whinis/CarRadio/README.md

# CarRadio
An atempt at making a fully featured car radio

There will be folders for each modules of the radio as well as one for the final board and all code needed to run the radio minus the si4689 firmware files
