whinis/CarRadio/Eagle/FmBoard/SI4689_Fm_Module.brd

## EAGLE design Eagle/FmBoard/SI4689_Fm_Module.brd (2016-11-11)

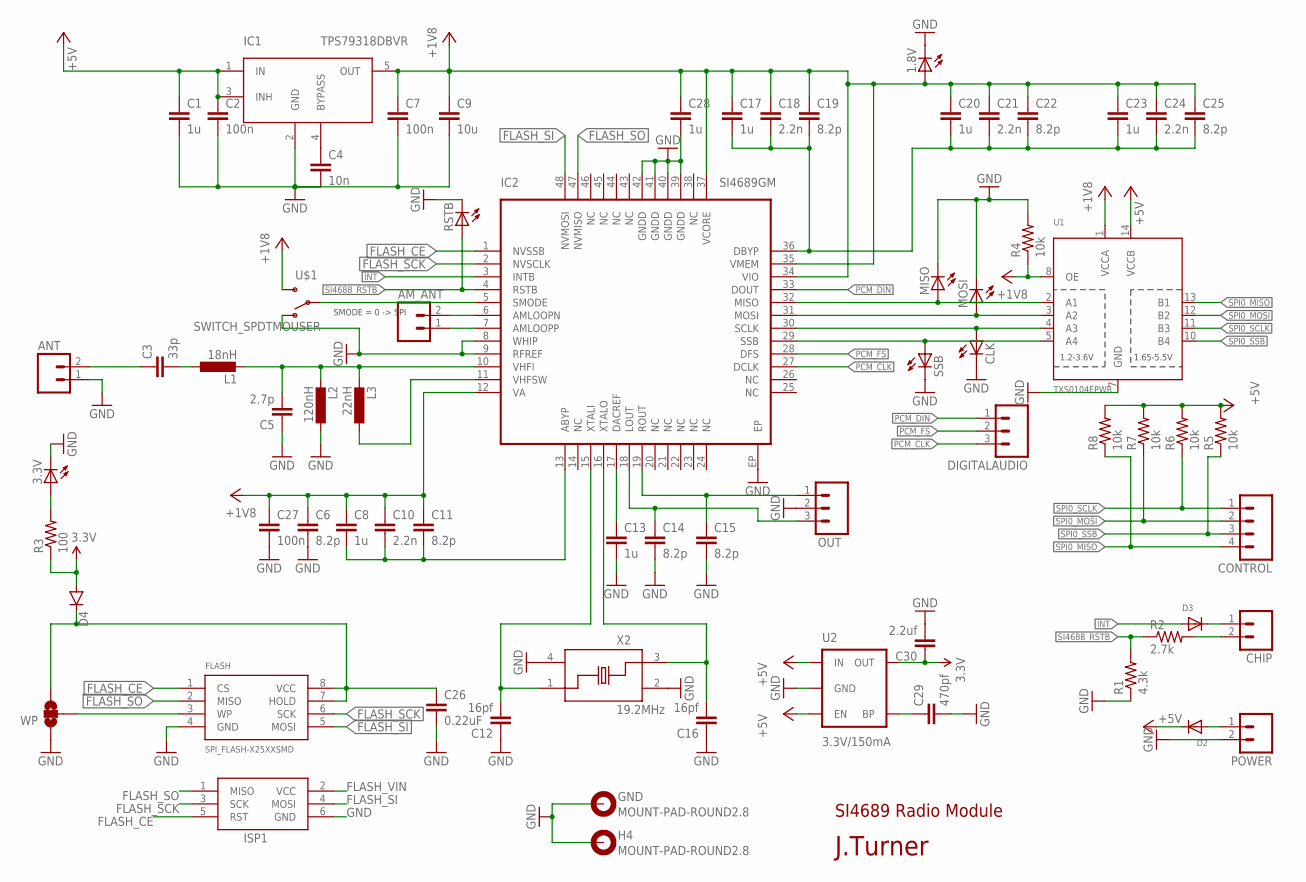
[picture p1: schematic SI4689_Fm_Module.sch]

Parts:
1.8V, 3.3V: LED_ESML0603; LED_SML0603
AM_ANT: M02; 02P
ANT: M02; 02P
C1, C8, C13, C17, C20, C23, C28: 1u; SMD0603
C2, C7, C27: 100n; SMD0603
C3: 33p; 0603-CAP
C4: 10n; SMD0603
C5: 2.7p; 0603-CAP
C6, C11, C14, C15, C19, C22, C25: 8.2p; SMD0603
C9: 10u; SMD0603
C10, C18, C21, C24: 2.2n; SMD0603
C12, C16: 16pf; 0603-CAP
C26: 0.22uF; 0603-CAP
C29: 470pf; 0603-CAP
C30: 2.2uf; 0603-CAP
CHIP: M02; 02P
CLK: LED_ESML0603; LED_SML0603
CONTROL: M04; 04P
D2, D3: DIODESOD-323F; SOD-323F
D4: DIODESOD523; SOD523
DIGITALAUDIO: M03; 03P
FLASH: SPI_FLASH-X25XXSMD; SO08
GND: MOUNT-PAD-ROUND2.8; 2,8-PAD
H4: MOUNT-PAD-ROUND2.8; 2,8-PAD
IC1: TPS79318DBVR; SOT23-5
IC2: SI4689GM; QFN48
ISP1: AVRISP-6; AVRISP
L1: 18nH; SMD0402
L2: 120nH; SMD0402
L3: 22nH; SMD0402
MISO: LED_ESML0603; LED_SML0603
MOSI: LED_ESML0603; LED_SML0603
OUT: M03; 03P
POWER: M02; 02P
R1: 4.3k; 0603-RES
R2: 2.7k; 0603-RES
R3: 100; 0603-RES
R4, R5, R6, R7, R8: 10k; 0603-RES
RSTB: LED_ESML0603; LED_SML0603
SSB: LED_ESML0603; LED_SML0603
U1: TXS0104EPWR; TSSOP14
U2: 3.3V/150mA; SOT23-5
U$1: SWITCH_SPDTMOUSER; SSSS810701
WP: SOLDERJUMPER_2WAYS; SJ_3
X2: 19.2MHz; XTAL_3.2X2.5

Connections:
3.3V: C30.1, D4.A, R3.1, U2.5 (OUT)
+1V8: 1.8V.A, C6.1, C7.1, C8.1, C9.1, C10.1, C11.1, C17.1, C18.1, C19.1, C20.1, C21.1, C22.1, C23.1, C24.1, C25.1, C27.1, C28.1, IC1.5 (OUT), IC2.12 (VA), IC2.34 (VIO), IC2.35 (VMEM), IC2.37 (VCORE), R4.1, U1.1 (VCCA), U1.8 (OE), U$1.S
FLASH_CE: FLASH.1 (CS), IC2.1 (NVSSB), ISP1.5 (RST)
FLASH_SCK: FLASH.6 (SCK), IC2.2 (NVSCLK), ISP1.3 (SCK)
FLASH_SI: FLASH.5 (MOSI), IC2.48 (NVMOSI), ISP1.4 (MOSI)
FLASH_SO: FLASH.2 (MISO), IC2.47 (NVMISO), ISP1.1 (MISO)
FLASH_VIN: C26.1, D4.C, FLASH.7 (HOLD), FLASH.8 (VCC), ISP1.2 (VCC), WP.3
GND: 1.8V.C, 3.3V.C, ANT.1, C1.2, C2.2, C4.2, C5.1, C6.2, C7.2, C9.2, C12.1, C13.2, C14.2, C15.2, C16.1, C26.2, C27.2, C28.2, C29.2, C30.2, CLK.C, FLASH.4 (GND), GND.B2,8, H4.B2,8, IC1.2 (GND), IC2.8 (WHIP), IC2.9 (RFREF), IC2.39 (GNDD), IC2.40 (GNDD), IC2.41 (GNDD), IC2.42 (GNDD), IC2.EP, ISP1.6 (GND), L2.1, MISO.C, MOSI.C, OUT.2, POWER.2, R1.1, R4.2, RSTB.C, SSB.C, U1.7 (GND), U2.2 (GND), U$1.O, WP.1, X2.2 (GND), X2.4 (GND)
INT: D3.A, IC2.3 (INTB)
LDO_IN: C1.1, C2.1, D2.C, IC1.1 (IN), IC1.3 (INH), R5.2, R6.2, R7.2, R8.2, U1.14 (VCCB), U2.1 (IN), U2.3 (EN)
unnamed: C3.2, L1.1
unnamed: C5.2, IC2.10 (VHFI), L1.2, L2.2, L3.2
unnamed: IC2.11 (VHFSW), L3.1
unnamed: C8.2, C10.2, C11.2, IC2.13 (ABYP)
unnamed: C17.2, C18.2, C19.2, C20.2, C21.2, C22.2, C23.2, C24.2, C25.2, IC2.36 (DBYP)
unnamed: C12.2, IC2.15 (XTALI), X2.1
unnamed: C16.2, IC2.16 (XTALO), X2.3
unnamed: C13.1, IC2.17 (DACREF)
unnamed: CHIP.1, D3.C
unnamed: C4.1, IC1.4 (BYPASS)
unnamed: C29.1, U2.4 (BP)
unnamed: 3.3V.A, R3.2
unnamed: FLASH.3 (WP), WP.2
unnamed: AM_ANT.1, IC2.7 (AMLOOPP)
unnamed: AM_ANT.2, IC2.6 (AMLOOPN)
unnamed: IC2.5 (SMODE), U$1.P
unnamed: CHIP.2, R2.2
unnamed: D2.A, POWER.1
PCM_CLK: DIGITALAUDIO.3, IC2.27 (DCLK)
PCM_DIN: DIGITALAUDIO.1, IC2.33 (DOUT)
PCM_FS: DIGITALAUDIO.2, IC2.28 (DFS)
RF_IN: ANT.2, C3.1
SI4688_LOUT: C14.1, IC2.18 (LOUT), OUT.3
SI4688_ROUT: C15.1, IC2.19 (ROUT), OUT.1
SI4688_RSTB: IC2.4 (RSTB), R1.2, R2.1, RSTB.A
SPI0_CE0_N18: IC2.29 (SSB), SSB.A, U1.5 (A4)
SPI0_MISO: CONTROL.4, R8.1, U1.13 (B1)
SPI0_MISO18: IC2.32 (MISO), MISO.A, U1.2 (A1)
SPI0_MOSI: CONTROL.2, R7.1, U1.12 (B2)
SPI0_MOSI18: IC2.31 (MOSI), MOSI.A, U1.3 (A2)
SPI0_SCLK: CONTROL.1, R6.1, U1.11 (B3)
SPI0_SCLK18: CLK.A, IC2.30 (SCLK), U1.4 (A3)
SPI0_SSB: CONTROL.3, R5.1, U1.10 (B4)

Notes on the sheet:
SI4689 Radio Module
SMODE = 0 -> SPI
J.Turner

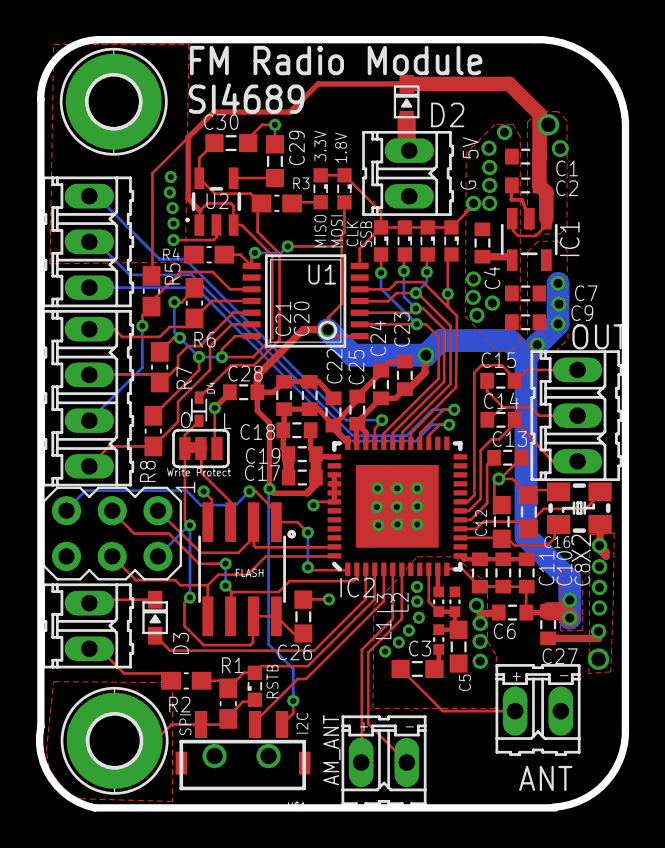
[picture p2: board SI4689_Fm_Module.brd from above]

Board: 2 copper layers, 32.5 x 42.7 mm, 69 parts (0 on the bottom side), 43 nets.
