whinis/CarRadio/Eagle/PowerBoard/power.brd

## EAGLE design Eagle/PowerBoard/power.brd (2016-03-05)

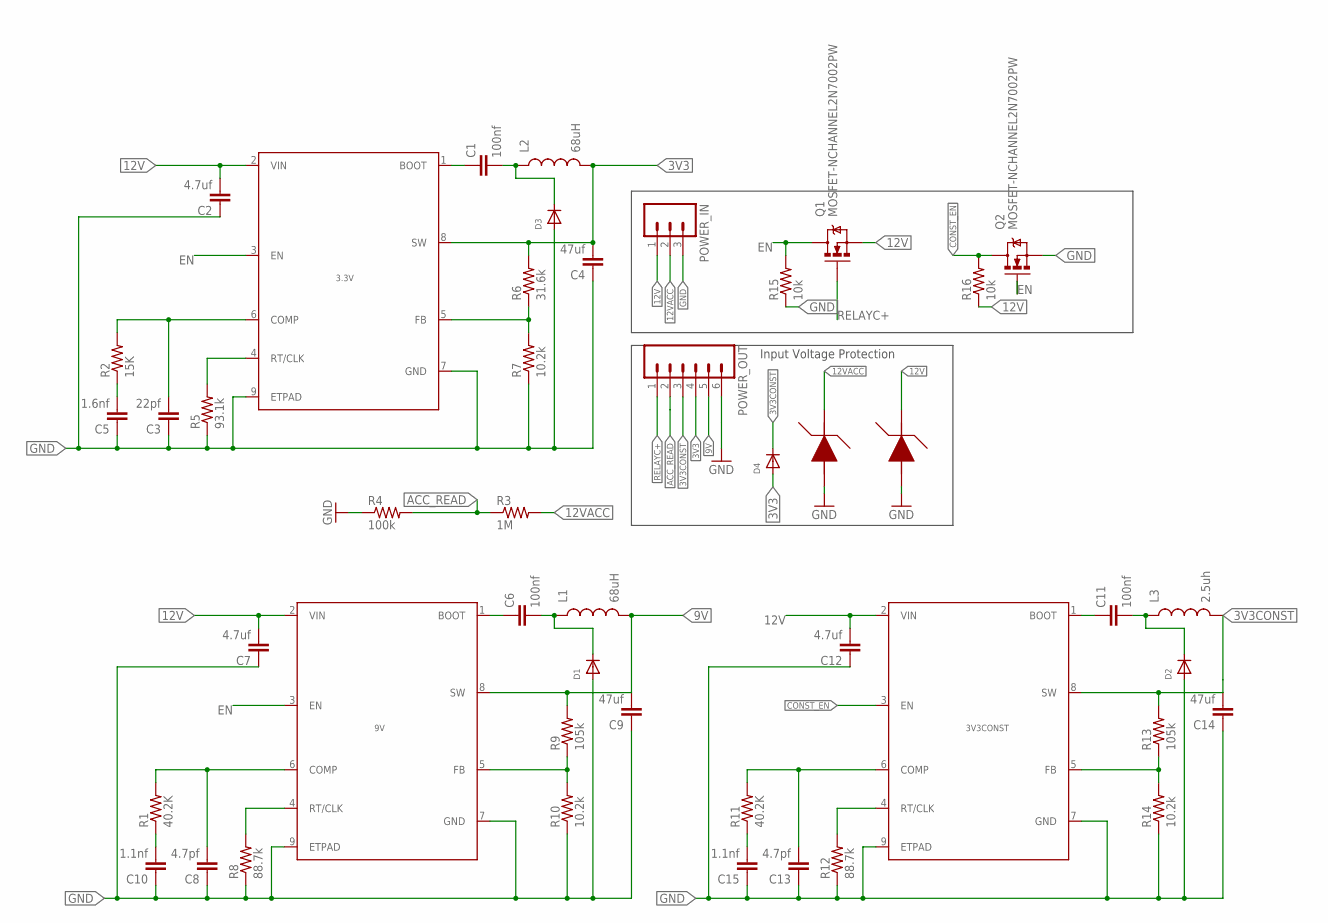
[picture p3: schematic power.sch]

Parts:
3.3V, 3V3CONST, 9V: TPS54340POWERPAD; DDA(R-PDSO-G08)
C1, C6, C11: 100nf; 0603-CAP
C2, C7, C12: 4.7uf; 0603-CAP
C3: 22pf; 0603-CAP
C4, C9, C14: 47uf; 0603-CAP
C5: 1.6nf; 0603-CAP
C8, C13: 4.7pf; 0603-CAP
C10, C15: 1.1nf; 0603-CAP
D1, D2, D3: DIODESOD-323F; SOD-323F
D4: DIODESOD-523; SOD-523
L1, L2: 68uH; CR75
L3: 2.5uh; CR54
POWER_IN: M03; 03P
POWER_OUT: M06; 06P
Q1, Q2: MOSFET-NCHANNEL2N7002PW; SOT323
R1, R11: 40.2K; 0603-RES
R2: 15K; 0603-RES
R3: 1M; 0603-RES
R4: 100k; 0603-RES
R5: 93.1k; 0603-RES
R6: 31.6k; 0603-RES
R7, R10, R14: 10.2k; 0603-RES
R8, R12: 88.7k; 0603-RES
R9, R13: 105k; 0603-RES
R15, R16: 10k; 0603-RES
U$3, U$5: SMCJ12A; DO-214AC

Connections:
3V3: 3.3V.8 (SW), C4.2, D4.A, L2.P$2 (2), POWER_OUT.4, R6.2
3V3CONST: 3V3CONST.8 (SW), C14.2, D4.K (C), L3.P$2 (2), POWER_OUT.3, R13.2
9V: 9V.8 (SW), C9.2, L1.P$2 (2), POWER_OUT.5, R9.2
12V: 3.3V.2 (VIN), 3V3CONST.2 (VIN), 9V.2 (VIN), C2.2, C7.2, C12.2, POWER_IN.1, Q1.2 (S), R16.1, U$5.NEG (GND)
12VACC: POWER_IN.2, R3.2, U$3.NEG (GND)
ACC_READ: POWER_OUT.2, R3.1, R4.2
CONST_EN: 3V3CONST.3 (EN), Q2.3 (D), R16.2
EN: 3.3V.3 (EN), 9V.3 (EN), Q1.3 (D), Q2.1 (G), R15.2
GND: 3.3V.7 (GND), 3.3V.9 (ETPAD), 3V3CONST.7 (GND), 3V3CONST.9 (ETPAD), 9V.7 (GND), 9V.9 (ETPAD), C2.1, C3.1, C4.1, C5.1, C7.1, C8.1, C9.1, C10.1, C12.1, C13.1, C14.1, C15.1, D1.A, D2.A, D3.A, POWER_IN.3, POWER_OUT.6, Q2.2 (S), R4.1, R5.1, R7.1, R8.1, R10.1, R12.1, R14.1, R15.1, U$3.POS (VIN), U$5.POS (VIN)
unnamed: C10.2, R1.1
unnamed: C5.2, R2.1
unnamed: 3.3V.6 (COMP), C3.2, R2.2
unnamed: 3.3V.4 (RT/CLK), R5.2
unnamed: C1.2, D3.C, L2.P$1 (1)
unnamed: 3.3V.5 (FB), R6.1, R7.2
unnamed: 9V.6 (COMP), C8.2, R1.2
unnamed: 3.3V.1 (BOOT), C1.1
unnamed: 9V.4 (RT/CLK), R8.2
unnamed: 9V.5 (FB), R9.1, R10.2
unnamed: 9V.1 (BOOT), C6.1
unnamed: C6.2, D1.C, L1.P$1 (1)
unnamed: C15.2, R11.1
unnamed: 3V3CONST.6 (COMP), C13.2, R11.2
unnamed: 3V3CONST.4 (RT/CLK), R12.2
unnamed: 3V3CONST.5 (FB), R13.1, R14.2
unnamed: 3V3CONST.1 (BOOT), C11.1
unnamed: C11.2, D2.C, L3.P$1 (1)
RELAYC+: POWER_OUT.1, Q1.1 (G)

Notes on the sheet:
Input Voltage Protection

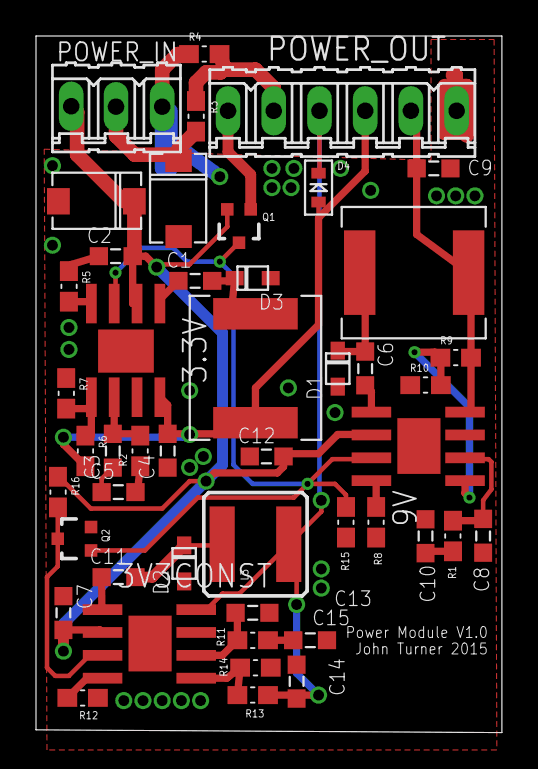
[picture p4: board power.brd from above]

Board: 2 copper layers, 25.9 x 38.7 mm, 47 parts (0 on the bottom side), 28 nets.
