whinis/CarRadio/Eagle/MainBoard/Combo Board.brd

## EAGLE design Eagle/MainBoard/Combo Board.brd (2016-03-05)

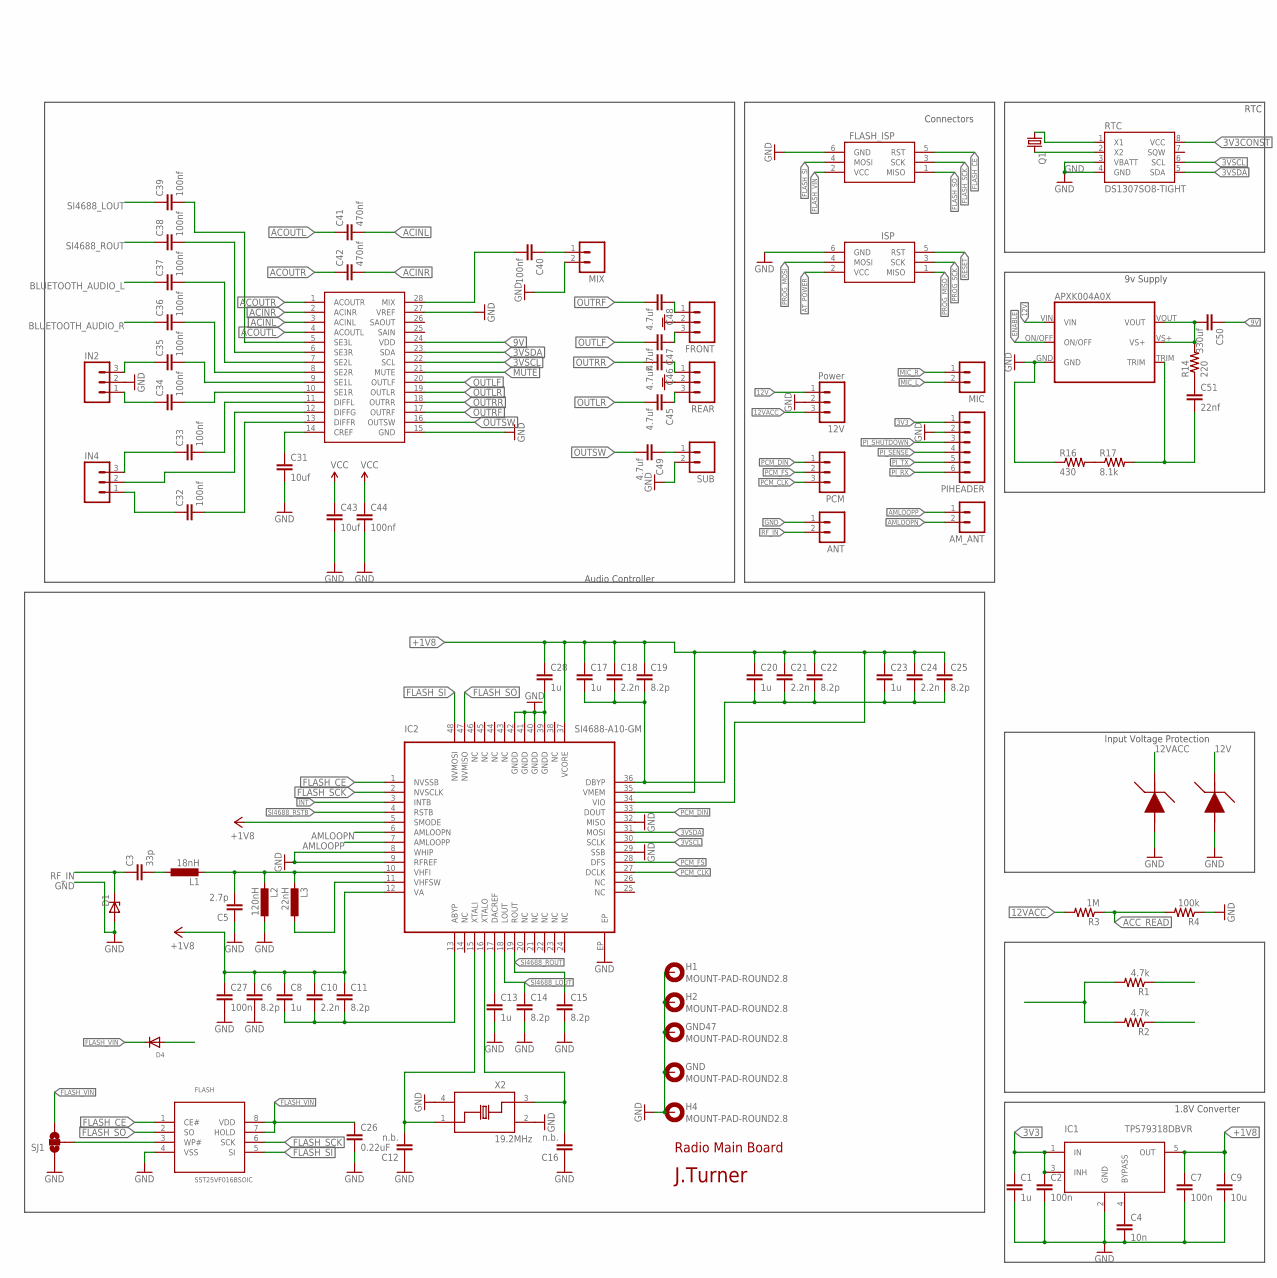
[picture p5: schematic Combo Board.sch, part in row 1, column 1]

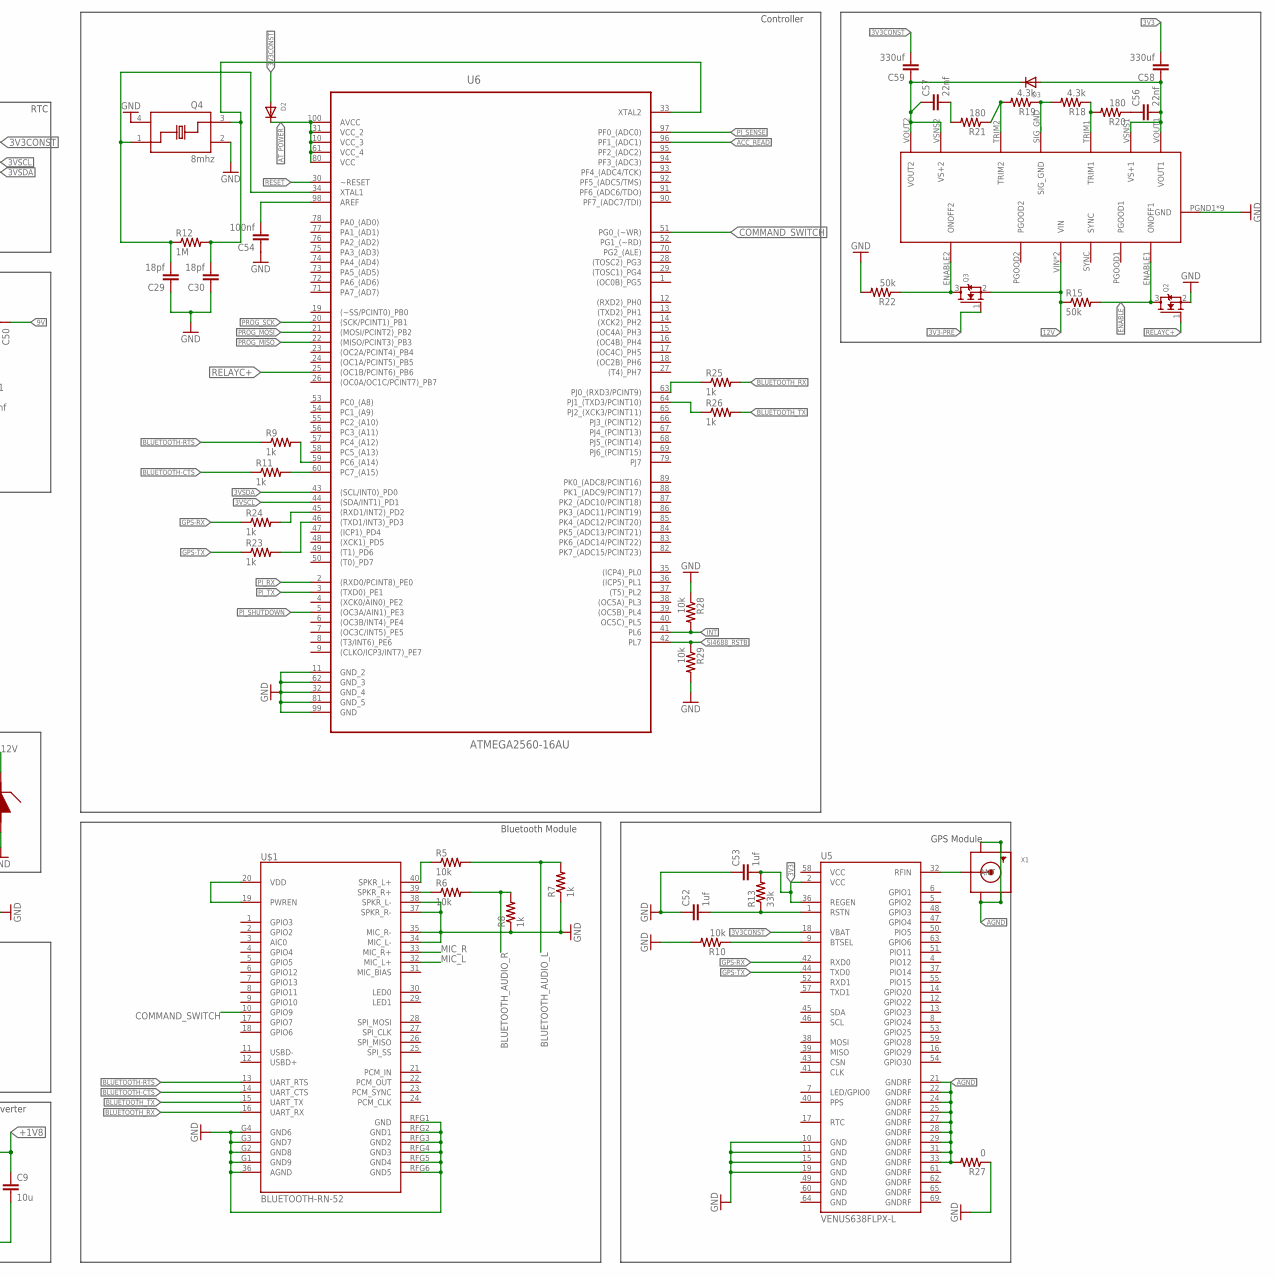
[picture p6: schematic Combo Board.sch, part in row 1, column 2]

Parts:
12V: Power; 03P
AM_ANT: M02; 02P
ANT: M02; 02P
APXK004A0X: APXW005A0X3-SRZ; APXW005A0X3
C1, C8, C13, C17, C20, C23, C28: 1u; SMD0603
C2, C7, C27: 100n; SMD0603
C3: 33p; 0603-CAP
C4: 10n; SMD0603
C5: 2.7p; 0603-CAP
C6, C11, C14, C15, C19, C22, C25: 8.2p; SMD0603
C9: 10u; SMD0603
C10, C18, C21, C24: 2.2n; SMD0603
C12, C16: n.b.; 0603-CAP
C26: 0.22uF; 0603-CAP
C29, C30: 18pf; 0603-CAP
C31, C43: 10uf; 0603-CAP
C32, C33, C34, C35, C36, C37, C38, C39, C40, C44, C54: 100nf; 0603-CAP
C41, C42: 470nf; 0603-CAP
C45, C46, C47, C48, C49: 4.7uf; 0603-CAP
C50, C58, C59: 330uf; 0603-CAP
C51, C56, C57: 22nf; 0603-CAP
C52, C53: 1uf; SMD0603
D1: ESD9L5.0; SOD923
D2: DIODESOD-123; SOD-123
D3, D4: DIODESOD-323F; SOD-323F
FLASH: SST25VF016BSOIC; SOIC8
FLASH_ISP: AVRISP-6; AVRISP
FRONT: M03PTH; 1X03
GND, GND47: MOUNT-PAD-ROUND2.8; 2,8-PAD
H1, H2, H4: MOUNT-PAD-ROUND2.8; 2,8-PAD
IC1: TPS79318DBVR; SOT23-5
IC2: SI4688-A10-GM; QFN48
IN2, IN4: M03; 03P
ISP: AVRISP-6; AVRISP
L1: 18nH; SMD0402
L2: 120nH; SMD0402
L3: 22nH; SMD0402
MIC: M02; 02P
MIX: M02; 02P
PCM: M03; 03P
PIHEADER: M06; 06P
Q1: CRYSTALTC26H_EZ; TC26HEZ
Q2, Q3: MOSFET-NREFLOW; SOT23
Q4: 8mhz; XTAL_3.2X2.5
R1, R2: 4.7k; 0603-RES
R3, R12: 1M; 0603-RES
R4: 100k; 0603-RES
R5, R6, R10, R28, R29: 10k; 0603-RES
R7, R8, R9, R11, R23, R24, R25, R26: 1k; 0603-RES
R13: 33k; 0603-RES
R14: 220; 0603-RES
R15, R22: 50k; 0603-RES
R16: 430; 0603-RES
R17: 8.1k; 0603-RES
R18, R19: 4.3k; 0603-RES
R20, R21: 180; 0603-RES
R27: 0; 0603-RES
REAR: M03PTH; 1X03
RTC: DS1307SO8-TIGHT; SO08-TIGHT
SJ1: SOLDERJUMPER_2WAYS; SJ_3
SUB: M02; 02P
TDA: TDA7419; SOIC-28
U5: VENUS638FLPX-L; VENUS638FLPX
U6: ATMEGA2560-16AU; QFP50P1600X1600X120-100N
U$1: BLUETOOTH-RN-52; RN-52
U$2, U$3: SMCJ12A; DO-214AC
U$4: UVXS0606A0X3-SRZ; UVXS0606
X1: SMACONNECTOR; SMA90_DIP
X2: 19.2MHz; XTAL_3.2X2.5

Connections:
3V3: C1.1, C2.1, C53.2, C58.2, D4.A, IC1.1 (IN), IC1.3 (INH), PIHEADER.1, R1.2, R2.2, R13.2, U5.2 (VCC), U5.36 (REGEN), U$1.19 (PWREN), U$1.20 (VDD)
3V3-PRE: C56.2, C58.1, D3.A, Q3.1 (G), U$4.VOUT1, U$4.VSNS1 (VS+1)
3V3CONST: C59.2, D2.A, RTC.8 (VCC), U5.18 (VBAT)
3VSCL: IC2.30 (SCLK), R1.1, RTC.6 (SCL), TDA.22 (SCL), U6.44 ((SDA/INT1)_PD1)
3VSDA: IC2.31 (MOSI), R2.1, RTC.5 (SDA), TDA.23 (SDA), U6.43 ((SCL/INT0)_PD0)
9V: C43.1, C44.1, C50.1, TDA.24 (VDD)
12V: 12V.1, APXK004A0X.VIN, Q3.2 (S), R15.1, U$3.NEG (GND), U$4.VIN, U$4.VIN2 (VIN)
12VACC: 12V.3, R3.2, U$2.NEG (GND)
+1V8: C6.1, C7.1, C8.1, C9.1, C10.1, C11.1, C17.1, C18.1, C19.1, C20.1, C21.1, C22.1, C23.1, C24.1, C25.1, C27.1, C28.1, IC1.5 (OUT), IC2.5 (SMODE), IC2.12 (VA), IC2.34 (VIO), IC2.35 (VMEM), IC2.37 (VCORE)
ACC_READ: R3.1, R4.2, U6.96 (PF1_(ADC1))
ACINL: C41.2, TDA.3 (ACINL)
ACINR: C42.2, TDA.2 (ACINR)
ACOUTL: C41.1, TDA.4 (ACOUTL)
ACOUTR: C42.1, TDA.1 (ACOUTR)
AGND: R27.2, U5.21 (GNDRF), U5.22 (GNDRF), U5.24 (GNDRF), U5.25 (GNDRF), U5.27 (GNDRF), U5.28 (GNDRF), U5.29 (GNDRF), U5.31 (GNDRF), U5.33 (GNDRF), X1.GND1, X1.GND2, X1.GND3, X1.GND4
AMLOOPN: AM_ANT.2, IC2.6 (AMLOOPN)
AMLOOPP: AM_ANT.1, IC2.7 (AMLOOPP)
AT_POWER: D2.C, ISP.2 (VCC), U6.10 (VCC_3), U6.31 (VCC_2), U6.61 (VCC_4), U6.80 (VCC), U6.100 (AVCC)
BLUETOOTH-CTS: R11.1, U$1.14 (UART_CTS)
BLUETOOTH-RTS: R9.1, U$1.13 (UART_RTS)
BLUETOOTH_AUDIO_L: C37.1, R5.2, R7.2
BLUETOOTH_AUDIO_R: C36.1, R6.2, R8.2
BLUETOOTH_RX: R25.2, U$1.16 (UART_RX)
BLUETOOTH_TX: R26.2, U$1.15 (UART_TX)
COMMAND_SWITCH: U6.51 (PG0_(~WR)), U$1.10 (GPIO9)
CREF: C31.1, TDA.14 (CREF)
DIFFG: IN4.2, TDA.12 (DIFFG)
DIFFL: C33.2, TDA.11 (DIFFL)
DIFFR: C32.2, TDA.13 (DIFFR)
ENABLE: APXK004A0X.ON/OFF, Q2.3 (D), R15.2, U$4.ENABLE1 (ONOFF1)
FLASH_CE: FLASH.1 (CE#), FLASH_ISP.5 (RST), IC2.1 (NVSSB)
FLASH_SCK: FLASH.6 (SCK), FLASH_ISP.3 (SCK), IC2.2 (NVSCLK)
FLASH_SI: FLASH.5 (SI), FLASH_ISP.4 (MOSI), IC2.48 (NVMOSI)
FLASH_SO: FLASH.2 (SO), FLASH_ISP.1 (MISO), IC2.47 (NVMISO)
FLASH_VIN: C26.1, D4.C, FLASH.7 (HOLD), FLASH.8 (VDD), FLASH_ISP.2 (VCC), SJ1.3
GND: 12V.2, ANT.1, APXK004A0X.GND, C1.2, C2.2, C4.2, C5.1, C6.2, C7.2, C9.2, C12.1, C13.2, C14.2, C15.2, C16.1, C26.2, C27.2, C28.2, C29.1, C30.1, C31.2, C43.2, C44.2, C52.1, C53.1, C54.1, D1.A, FLASH.4 (VSS), FLASH_ISP.6 (GND), FRONT.2, GND.B2,8, GND47.B2,8, H1.B2,8, H2.B2,8, H4.B2,8, IC1.2 (GND), IC2.8 (WHIP), IC2.9 (RFREF), IC2.29 (SSB), IC2.32 (MISO), IC2.39 (GNDD), IC2.40 (GNDD), IC2.41 (GNDD), IC2.42 (GNDD), IC2.EP, IN2.2, ISP.6 (GND), L2.1, MIX.2, PIHEADER.2, Q2.2 (S), Q4.2 (GND), Q4.4 (GND), R4.1, R7.1, R8.1, R10.2, R16.1, R22.2, R27.1, R28.1, R29.2, REAR.2, RTC.3 (VBATT), RTC.4 (GND), SJ1.1, SUB.2, TDA.15 (GND), TDA.27 (VREF), U5.10 (GND), U5.11 (GND), U5.15 (GND), U5.19 (GND), U6.11 (GND_2), U6.32 (GND_4), U6.62 (GND_3), U6.81 (GND_5), U6.99 (GND), U$1.34 (MIC_L-), U$1.35 (MIC_R-), U$1.36 (AGND), U$1.37 (SPKR_R-), U$1.38 (SPKR_L-), U$1.G1 (GND9), U$1.G2 (GND8), U$1.G3 (GND7), U$1.G4 (GND6), U$1.RFG1 (GND), U$1.RFG2 (GND1), U$1.RFG3 (GND2), U$1.RFG4 (GND3), U$1.RFG5 (GND4), U$1.RFG6 (GND5), U$2.POS (VIN), U$3.POS (VIN), U$4.PGND1 (GND), U$4.PGND2 (GND), U$4.PGND3 (GND), U$4.PGND4 (GND), U$4.PGND5 (GND), U$4.PGND6 (GND), U$4.PGND7 (GND), U$4.PGND8 (GND), U$4.PGND9 (GND), X2.2 (GND), X2.4 (GND)
GPS-RX: R24.1, U5.42 (RXD0)
GPS-TX: R23.1, U5.44 (TXD0)
INT: IC2.3 (INTB), R28.2, U6.41 (PL6)
MIC_L: MIC.2, U$1.32 (MIC_L+)
MIC_R: MIC.1, U$1.33 (MIC_R+)
MIX: C40.2, TDA.28 (MIX)
MUTE: TDA.21 (MUTE)
unnamed: C3.2, L1.1
unnamed: C5.2, IC2.10 (VHFI), L1.2, L2.2, L3.2
unnamed: IC2.11 (VHFSW), L3.1
unnamed: C8.2, C10.2, C11.2, IC2.13 (ABYP)
unnamed: C17.2, C18.2, C19.2, C20.2, C21.2, C22.2, C23.2, C24.2, C25.2, IC2.36 (DBYP)
unnamed: C12.2, IC2.15 (XTALI), X2.1
unnamed: C16.2, IC2.16 (XTALO), X2.3
unnamed: C13.1, IC2.17 (DACREF)
unnamed: R9.2, U6.59 (PC6_(A14))
unnamed: C4.1, IC1.4 (BYPASS)
unnamed: R11.2, U6.60 (PC7_(A15))
unnamed: C30.2, Q4.3, R12.2, U6.33 (XTAL2)
unnamed: FLASH.3 (WP#), SJ1.2
unnamed: R5.1, U$1.40 (SPKR_L+)
unnamed: R6.1, U$1.39 (SPKR_R+)
unnamed: APXK004A0X.TRIM, C51.2, R17.2
unnamed: C40.1, MIX.1
unnamed: Q1.2, RTC.2 (X2)
unnamed: Q1.1, RTC.1 (X1)
unnamed: C35.1, IN2.3
unnamed: C34.1, IN2.1
unnamed: R23.2, U6.46 ((TXD1/INT3)_PD3)
unnamed: C29.2, Q4.1, R12.1, U6.34 (XTAL1)
unnamed: C33.1, IN4.3
unnamed: C32.1, IN4.1
unnamed: R24.2, U6.45 ((RXD1/INT2)_PD2)
unnamed: R16.2, R17.1
unnamed: R10.1, U5.9 (BTSEL)
unnamed: C52.2, R13.1, U5.1 (RSTN)
unnamed: C48.1, FRONT.1
unnamed: C47.1, FRONT.3
unnamed: C46.1, REAR.1
unnamed: C45.1, REAR.3
unnamed: C49.1, SUB.1
unnamed: APXK004A0X.VOUT, APXK004A0X.VS+, C50.2, R14.2
unnamed: C51.1, R14.1
unnamed: R19.2, R21.1, U$4.TRIM2
unnamed: R18.1, R20.2, U$4.TRIM1
unnamed: C56.1, R20.1
unnamed: C57.2, R21.2
unnamed: R18.2, R19.1, U$4.SIG_GND
unnamed: C57.1, C59.1, D3.C, U$4.VOUT2, U$4.VSNS2 (VS+2)
unnamed: R25.1, U6.63 (PJ0_(RXD3/PCINT9))
unnamed: R26.1, U6.64 (PJ1_(TXD3/PCINT10))
unnamed: Q3.3 (D), R22.1, U$4.ENABLE2 (ONOFF2)
unnamed: C54.2, U6.98 (AREF)
unnamed: U5.32 (RFIN), X1.ANTENNA (ANT)
OUTLF: C47.2, TDA.20 (OUTLF)
OUTLR: C45.2, TDA.19 (OUTLR)
OUTRF: C48.2, TDA.17 (OUTRF)
OUTRR: C46.2, TDA.18 (OUTRR)
OUTSW: C49.2, TDA.16 (OUTSW)
PCM_CLK: IC2.27 (DCLK), PCM.3
PCM_DIN: IC2.33 (DOUT), PCM.1
PCM_FS: IC2.28 (DFS), PCM.2
PI_RX: PIHEADER.6, U6.2 ((RXD0/PCINT8)_PE0)
PI_SENSE: PIHEADER.4, U6.97 (PF0_(ADC0))
PI_SHUTDOWN: PIHEADER.3, U6.5 ((OC3A/AIN1)_PE3)
PI_TX: PIHEADER.5, U6.3 ((TXD0)_PE1)
PROG_MISO: ISP.1 (MISO), U6.22 ((MISO/PCINT3)_PB3)
PROG_MOSI: ISP.4 (MOSI), U6.21 ((MOSI/PCINT2)_PB2)
PROG_SCK: ISP.3 (SCK), U6.20 ((SCK/PCINT1)_PB1)
RELAYC+: Q2.1 (G), U6.25 ((OC1B/PCINT6)_PB6)
RESET: ISP.5 (RST), U6.30 (~RESET)
RF_IN: ANT.2, C3.1, D1.K (C)
SE1L: C35.2, TDA.9 (SE1L)
SE1R: C34.2, TDA.10 (SE1R)
SE2L: C37.2, TDA.7 (SE2L)
SE2R: C36.2, TDA.8 (SE2R)
SE3L: C39.2, TDA.5 (SE3L)
SE3R: C38.2, TDA.6 (SE3R)
SI4688_LOUT: C14.1, C39.1, IC2.18 (LOUT)
SI4688_ROUT: C15.1, C38.1, IC2.19 (ROUT)
SI4688_RSTB: IC2.4 (RSTB), R29.1, U6.42 (PL7)

Notes on the sheet:
Radio Main Board
J.Turner
RTC
Audio Controller
1.8V Converter
Input Voltage Protection
9v Supply
Connectors
Controller
GPS Module
Bluetooth Module

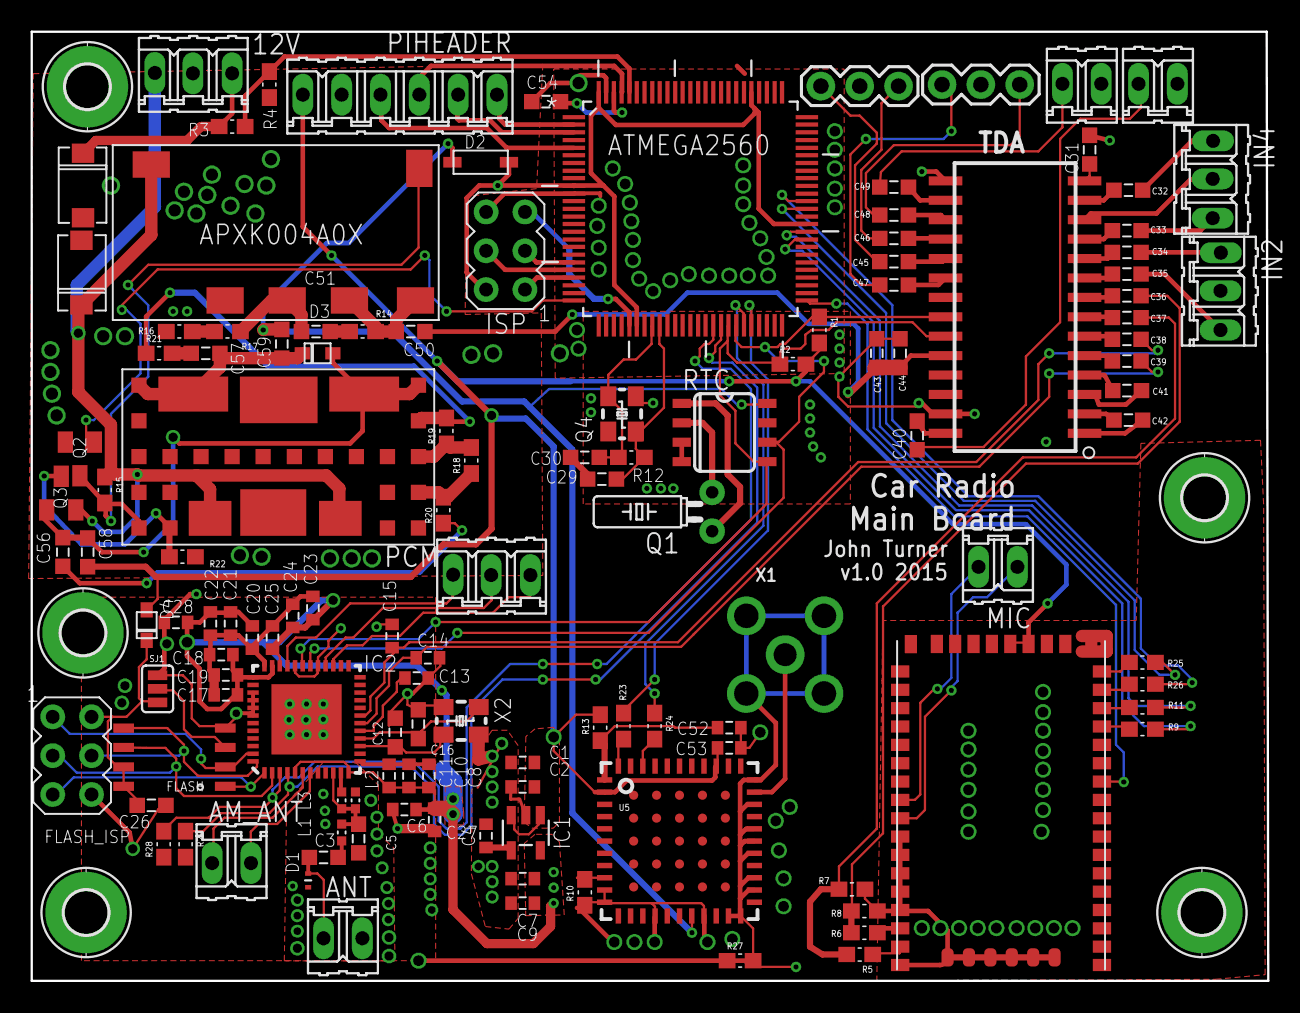
[picture p7: board Combo Board.brd from above]

Board: 2 copper layers, 80.9 x 62.1 mm, 132 parts (0 on the bottom side), 116 nets.
