whinis/CarRadio/Eagle/AudioRtcBoard/TDA7419 .brd

## EAGLE design Eagle/AudioRtcBoard/TDA7419 .brd (2016-03-05)

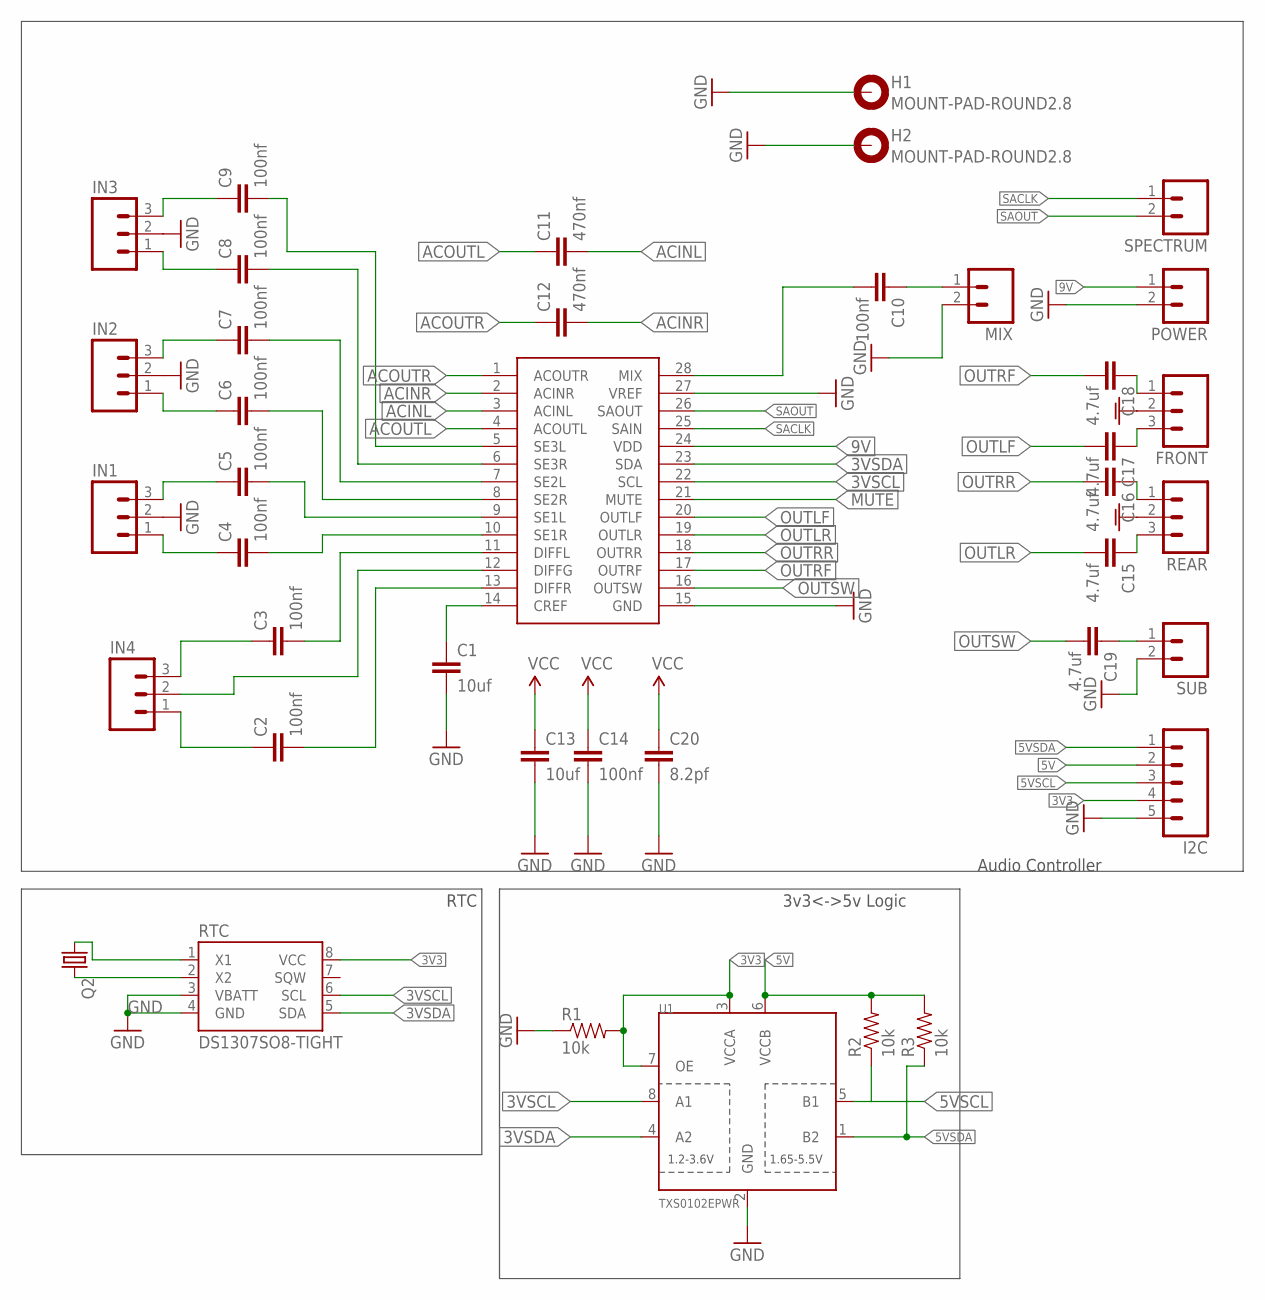
[picture p8: schematic TDA7419 .sch]

Parts:
C1, C13: 10uf; 0603-CAP
C2, C3, C4, C5, C6, C7, C8, C9, C10, C14: 100nf; 0603-CAP
C11, C12: 470nf; 0603-CAP
C15, C16, C17, C18, C19: 4.7uf; 0603-CAP
C20: 8.2pf; 0603-CAP
FRONT: M03PTH; 1X03
H1, H2: MOUNT-PAD-ROUND2.8; 2,8-PAD
I2C: M05; 05P
IN1, IN2, IN3, IN4: M03; 03P
MIX: M02; 02P
POWER: M02; 02P
Q2: CRYSTALTC26H_EZ; TC26HEZ
R1, R2, R3: 10k; 0603-RES
REAR: M03PTH; 1X03
RTC: DS1307SO8-TIGHT; SO08-TIGHT
SPECTRUM: M02; 02P
SUB: M02; 02P
TDA: TDA7419; SOIC-28
U1: TXS0102EPWR; TSSOP8

Connections:
3V3: I2C.4, R1.2, RTC.8 (VCC), U1.3 (VCCA), U1.7 (OE)
3VSCL: RTC.6 (SCL), TDA.22 (SCL), U1.8 (A1)
3VSDA: RTC.5 (SDA), TDA.23 (SDA), U1.4 (A2)
5V: I2C.2, R2.2, R3.2, U1.6 (VCCB)
5VSCL: I2C.3, R2.1, U1.5 (B1)
5VSDA: I2C.1, R3.1, U1.1 (B2)
9V: C13.1, C14.1, C20.1, POWER.1, TDA.24 (VDD)
ACINL: C11.2, TDA.3 (ACINL)
ACINR: C12.2, TDA.2 (ACINR)
ACOUTL: C11.1, TDA.4 (ACOUTL)
ACOUTR: C12.1, TDA.1 (ACOUTR)
CREF: C1.1, TDA.14 (CREF)
DIFFG: IN4.2, TDA.12 (DIFFG)
DIFFL: C3.2, TDA.11 (DIFFL)
DIFFR: C2.2, TDA.13 (DIFFR)
GND: C1.2, C13.2, C14.2, C20.2, FRONT.2, H1.B2,8, H2.B2,8, I2C.5, IN1.2, IN2.2, IN3.2, MIX.2, POWER.2, R1.1, REAR.2, RTC.3 (VBATT), RTC.4 (GND), SUB.2, TDA.15 (GND), TDA.27 (VREF), U1.2 (GND)
MIX: C10.2, TDA.28 (MIX)
MUTE: TDA.21 (MUTE)
unnamed: C10.1, MIX.1
unnamed: C9.1, IN3.3
unnamed: C8.1, IN3.1
unnamed: C7.1, IN2.3
unnamed: C6.1, IN2.1
unnamed: C5.1, IN1.3
unnamed: C4.1, IN1.1
unnamed: C3.1, IN4.3
unnamed: C2.1, IN4.1
unnamed: C18.1, FRONT.1
unnamed: C17.1, FRONT.3
unnamed: C16.1, REAR.1
unnamed: C15.1, REAR.3
unnamed: C19.1, SUB.1
unnamed: Q2.2, RTC.2 (X2)
unnamed: Q2.1, RTC.1 (X1)
OUTLF: C17.2, TDA.20 (OUTLF)
OUTLR: C15.2, TDA.19 (OUTLR)
OUTRF: C18.2, TDA.17 (OUTRF)
OUTRR: C16.2, TDA.18 (OUTRR)
OUTSW: C19.2, TDA.16 (OUTSW)
SACLK: SPECTRUM.1, TDA.25 (SAIN)
SAOUT: SPECTRUM.2, TDA.26 (SAOUT)
SE1L: C5.2, TDA.9 (SE1L)
SE1R: C4.2, TDA.10 (SE1R)
SE2L: C7.2, TDA.7 (SE2L)
SE2R: C6.2, TDA.8 (SE2R)
SE3L: C9.2, TDA.5 (SE3L)
SE3R: C8.2, TDA.6 (SE3R)

Notes on the sheet:
Audio Controller
RTC
3v3<->5v Logic

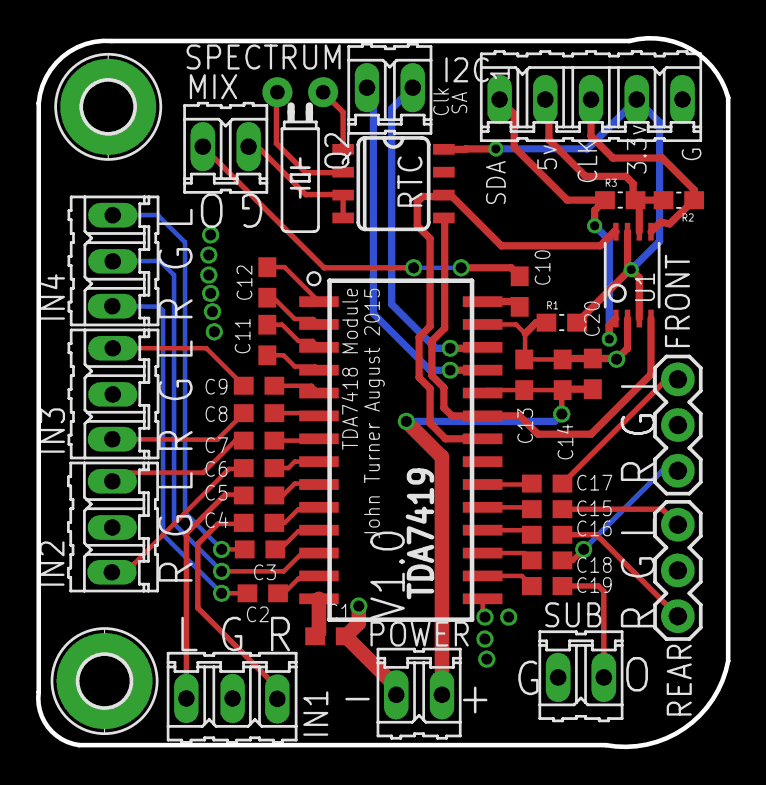
[picture p9: board TDA7419 .brd from above]

Board: 2 copper layers, 38.3 x 39.4 mm, 40 parts (0 on the bottom side), 46 nets.
