whinis/CarRadio/(commit log)

2016-03-05 Initial Commit of the private work I have done so far
    [Combo Board.brd, Combo Board.sch, SI4689_Fm_Module.brd, SI4689_Fm_Module.sch, TDA7419 .brd, TDA7419 .sch, power.brd, power.sch]
2016-06-12 Small update and removing of the FirmwareLoader that doesn't work.
    [RadioController.ino, SI468X.cpp, SI468X.h]
2016-11-11 Updated to the now working v1.7 of the radio module Made Radio Module arudino compatible so that it can be plugged directly into the arudino Moved to a S25FL132K0XMFI041 flash chip due to being cheap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
    [SI4689_Fm_Module.brd, SI4689_Fm_Module.sch]
2016-11-11 Initial commit of my python application that communicates with the SI468x series radio chip Basic commands for now and communicates of a ft232h chip over usb Switched to python and ft232h instead of 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
